alexew0923/BWB_Weather_Station/Medicine_Garden/Assets/Sprites/Garden.jpg

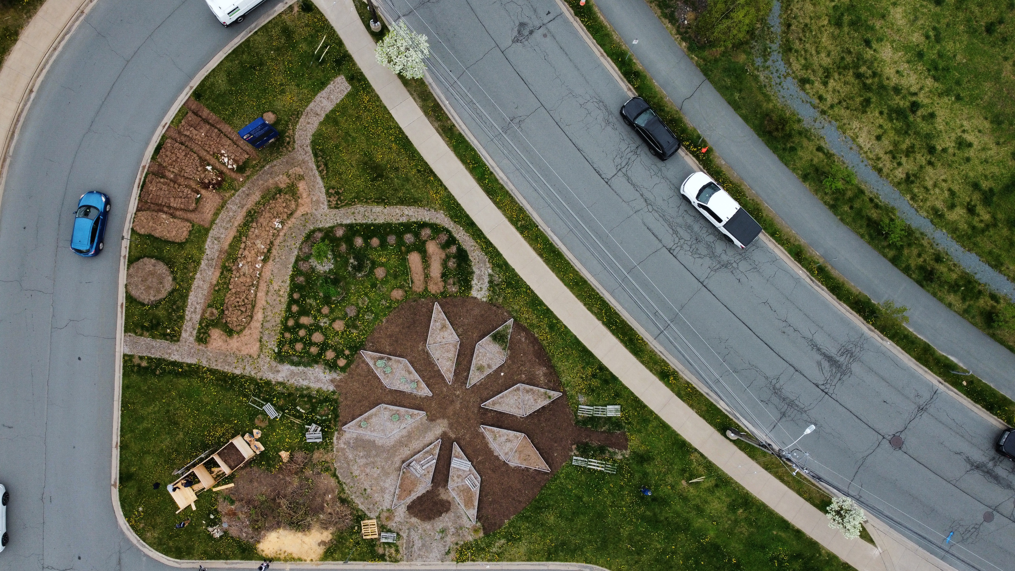
Medicine_Garden/Assets/Sprites/Garden.jpg
