alexew0923/BWB_Weather_Station/(commit log)

2025-12-03 Circuit Diagram
2025-12-06 v2 circuit diagram
2025-12-06 v3 circuit diagram
2025-12-06 v4 circuit diagram
2025-12-06 v5 circuit diagram
2025-12-06 v6 circuit diagram
2025-12-06 circuit diagrams
2025-12-06 Update and rename ESP32_Online_Weather_Station_Receiver.ino to Codes/Weather_Station/Receiver.ino
2026-05-15 Add daily reliability audit function
    This function rebuilds the daily reliability audit by processing historical data from a spreadsheet. It checks for necessary columns, counts the presence of sensor data, and outputs the results to a designated audit sheet.
2026-08-10 Enhance archiveOldSensorData with success rate
    Added success rate calculation for sensor data transmissions.
    Removed this process from reliabilityAudit.js
2026-08-29 Added initial battery / energy analysis output + CLI overview
2026-08-29 Added Streamlit visual dashboard to portray battery analysis
2026-08-29 Add historical sensor health analysis
2026-08-29 Added centralized dashboard app to view live station health and battery analysis
2026-08-29 Implemented Google Sheets URL normalization for live battery analytics
