alexew0923/BWB_Weather_Station/Medicine_Garden/Assets/Sprites/Plants/Cedar.jpg

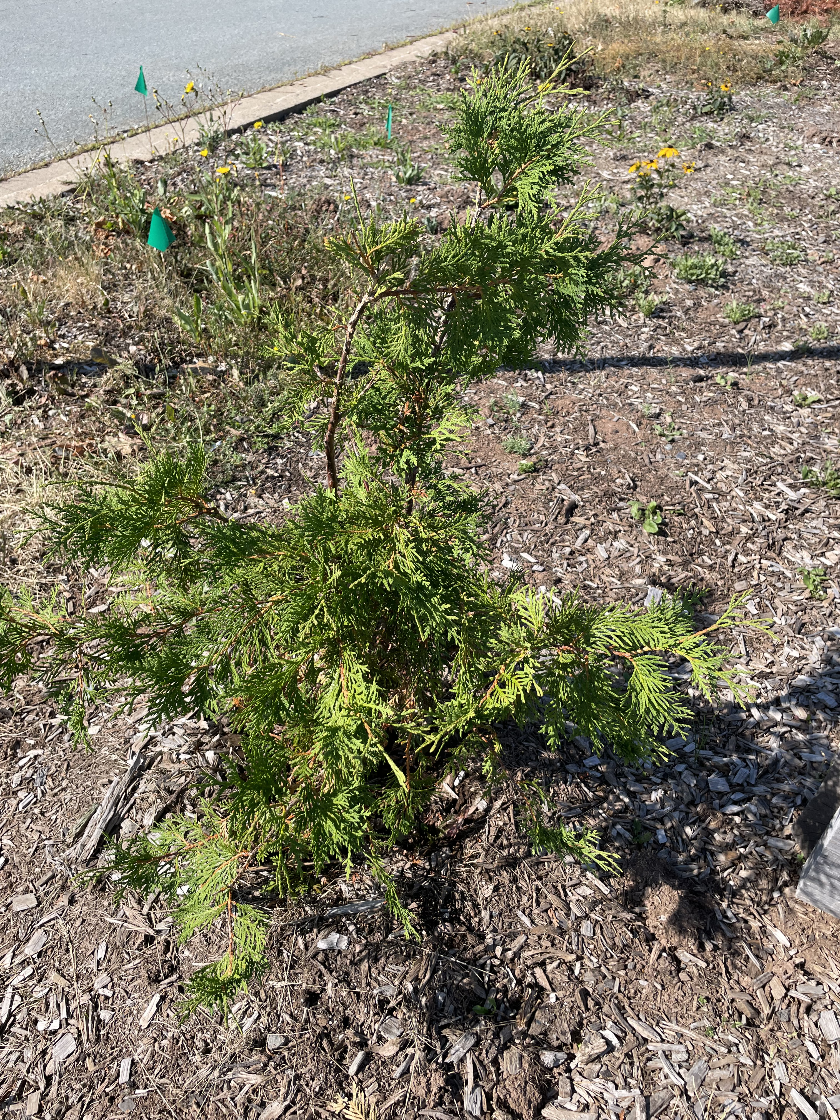
Medicine_Garden/Assets/Sprites/Plants/Cedar.jpg
