alexew0923/BWB_Weather_Station/Medicine_Garden/Assets/Sprites/Plants/Sweetgrass.jpg

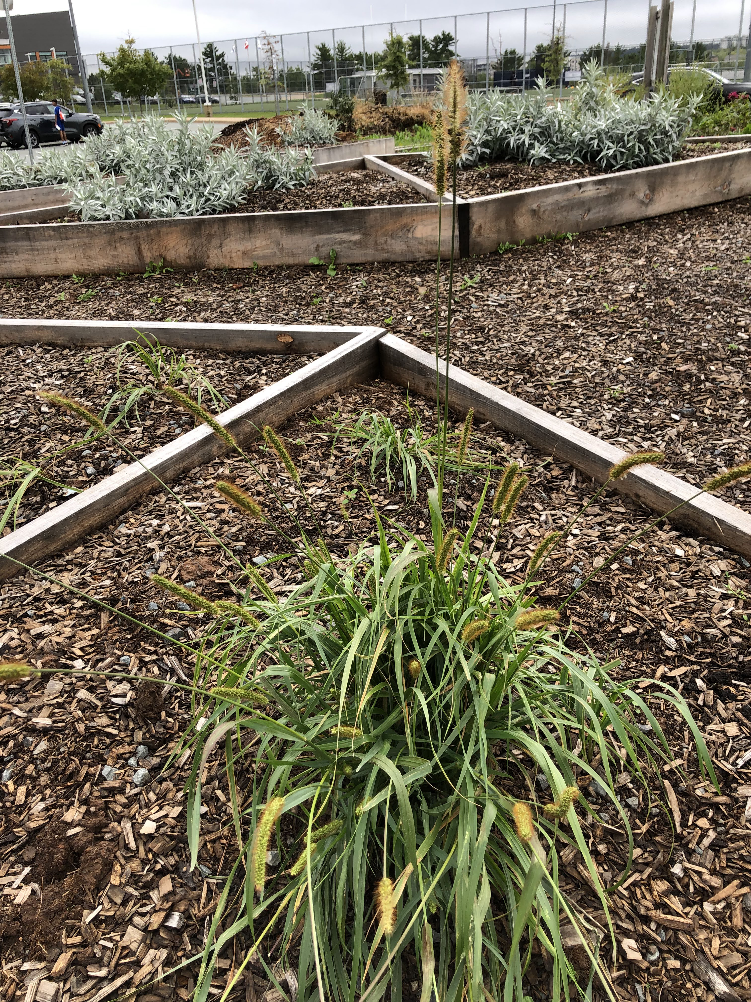
Medicine_Garden/Assets/Sprites/Plants/Sweetgrass.jpg
