alexew0923/BWB_Weather_Station/Medicine_Garden/Assets/Sprites/Plants/Tobacco.jpg

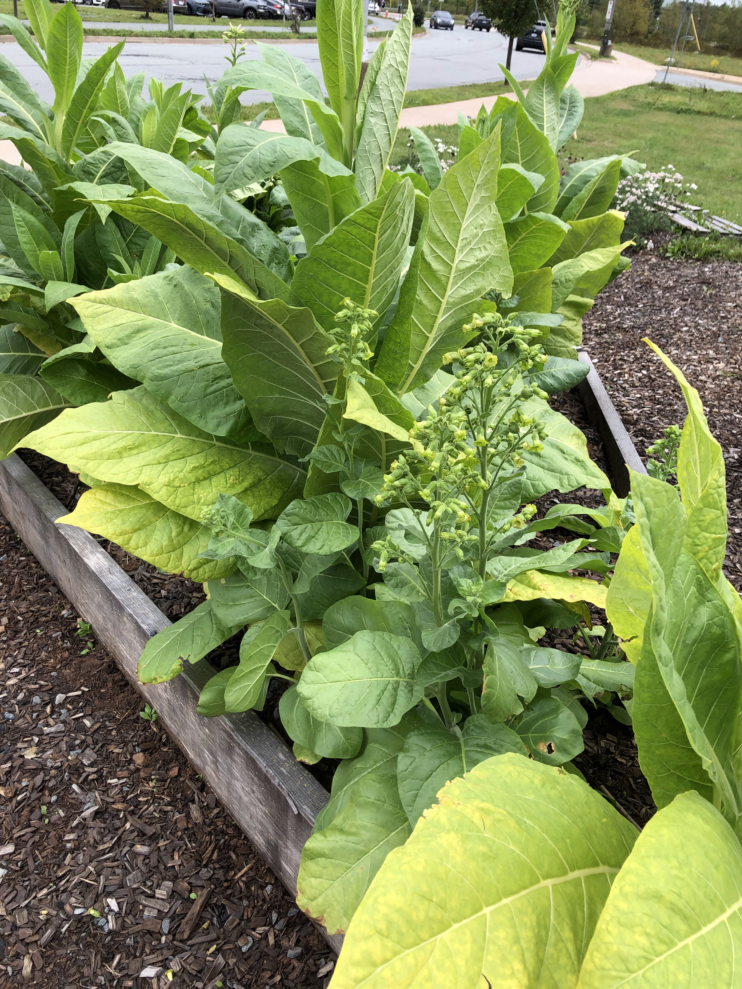
Medicine_Garden/Assets/Sprites/Plants/Tobacco.jpg
